shivamchudasama/KiaSorentoKeyCover_3DPrinting/(list of files, cad)

Other CAD files:
Hinge/hinge_rugged_upper_kia.stl
Magnet/magnet_trail_upper_kia.stl
Original/digital_only.stl
Snap/snap_ridge.3mf
Split/upper_flat.stl
Hinge/hinge_trail_upper_accent.stl
Magnet/magnet_ridge_upper_kia.stl
Original/from_openscad.stl
Snap/snap_trail_upper_kia.stl
Split/lower_flat.stl
Hinge/hinge_upper_kia.stl
Magnet/magnet_upper.stl
Snap/snap_ridge_upper_kia.stl
Hinge/hinge_trail_upper.stl
Magnet/magnet_trail_upper.stl
Snap/snap_upper.stl
Hinge/hinge_rugged_upper_accent.stl
Magnet/magnet_rugged_upper.stl
Snap/snap_ridge_upper.stl
Hinge/hinge_trail_upper_kia.stl
Magnet/magnet_upper_kia.stl
Snap/snap_rugged_upper.stl
Hinge/hinge_rugged_upper.stl
Magnet/magnet_rugged_upper_accent.stl
Snap/snap_trail_upper_accent.stl
Hinge/hinge_ridge_upper_kia.stl
Magnet/magnet_trail_upper_accent.stl
Snap/snap_rugged_upper_accent.stl
Hinge/hinge_ridge_upper.stl
Magnet/magnet_ridge_upper.stl
Snap/snap_trail_upper.stl
Hinge/hinge_upper.stl
Magnet/magnet_rugged_upper_kia.stl
Snap/snap_rugged_upper_kia.stl
Hinge/hinge_rugged_lower_accent.stl
Magnet/magnet_rugged_lower.stl
Snap/snap_upper_kia.stl
Hinge/hinge_rugged_lower.stl
Magnet/magnet_trail_lower_kia.stl
Snap/snap_rugged_lower.stl
Hinge/hinge_ridge_lower.stl
Magnet/magnet_ridge_lower_kia.stl
Snap/snap_rugged_lower_accent.stl
Hinge/hinge_trail_lower.stl
Magnet/magnet_lower_kia.stl
Snap/snap_trail_lower.stl
Hinge/hinge_lower.stl
Magnet/magnet_trail_lower.stl
Snap/snap_coupon.stl
Hinge/hinge_trail_lower_accent.stl
Magnet/magnet_trail_lower_accent.stl
Snap/snap_ridge_lower.stl
Hinge/hinge_lower_kia.stl
Magnet/magnet_lower.stl
Snap/snap_lower.stl
Hinge/hinge_rugged_lower_kia.stl
Magnet/magnet_ridge_lower.stl
Snap/snap_trail_lower_accent.stl
Hinge/hinge_ridge_lower_kia.stl
Magnet/magnet_rugged_lower_kia.stl
Snap/snap_lower_kia.stl
Hinge/hinge_trail_lower_kia.stl
Magnet/magnet_rugged_lower_accent.stl
Snap/snap_ridge_lower_kia.stl
Hinge/hinge_coupon.stl
Magnet/magnet_coupon.stl
Snap/snap_rugged_lower_kia.stl
Snap/snap_trail_lower_kia.stl
Original/split_grip_ridge.scad
kia_sorento_key_case_split.scad
Hinge/hinge_ridge.scad
Hinge/hinge_rugged.scad
Hinge/hinge_trail.scad
Magnet/magnet.scad
Magnet/magnet_ridge.scad
Magnet/magnet_rugged.scad
Magnet/magnet_trail.scad
Original/split.scad
Original/split_rugged.scad
Original/split_trail.scad
Snap/snap.scad
Snap/snap_ridge.scad
Snap/snap_trail.scad
Split/flat.scad
