shivamchudasama/KiaSorentoKeyCover_3DPrinting/(commit log)

2026-10-31 Add Kia Sorento key case: parametric source, exports and previews
    Two-part ASA case for the Kia Sorento digital key fob, split at Z = 0
    with selectable snap / hinge / magnet joints. STL and GLB files are
    stored in Git LFS; .codex/ local tool config is ignored.
    [kia_sorento_key_case_digital_only.scad, kia_sorento_key_case_digital_only.stl, kia_sorento_key_case_from_openscad.stl, kia_sorento_key_case_hinge_coupon.stl, kia_sorento_key_case_hinge_lower.stl, kia_sorento_key_case_hinge_upper.stl, kia_sorento_key_case_lower_flat.stl, kia_sorento_key_case_magnet_coupon.stl]
2026-10-31 Move snap and hinge latches off the button windows
    The latches covered the side windows that expose the fob's buttons.
    They now sit on the solid wall posts, each inside a local wall pad
    that encloses its pocket, so no new opening appears. Hooks use a 60°
    retaining face so the halves pull apart by hand.
    [kia_sorento_key_case_hinge_lower.stl, kia_sorento_key_case_hinge_upper.stl, kia_sorento_key_case_snap_lower.stl, kia_sorento_key_case_snap_upper.stl, kia_sorento_key_case_split.scad]
2026-10-31 Add grip-ridge variant of the snap and hinge cases
    Exploratory copy of the source with two pairs of opposing ridges, one
    ridge per half in each pair: round the top arc and along the open end.
    Their seam-side faces give a grip for pulling the halves apart. Each
    pair has its own on/off switch. The main design is unchanged.
    [kia_sorento_key_case_hinge_ridge_lower.stl, kia_sorento_key_case_hinge_ridge_upper.stl, kia_sorento_key_case_snap_ridge_lower.stl, kia_sorento_key_case_snap_ridge_upper.stl, kia_sorento_key_case_split_grip_ridge.scad]
2026-10-31 Organise files into per-design folders with short names
    Move the shared source and its inputs (master .scad files, base STL,
    logo, digital-only step) into Original/, and each design's exports into
    Snap/, Hinge/, Magnet/ and Split/. Drop the kia_sorento_key_case_ prefix
    from every file name.
    Each design folder gets a thin .scad wrapper that includes the master
    from Original/ and fixes joint_style, so a design can be opened on its
    own while all parameters stay in one place. The masters change only in
    the base STL's import path.
    Every exported part renders byte-identical through the wrappers to the
    previous layout; the snap, hinge and magnet renders also match the
    committed STLs byte for byte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
    [digital_only.scad, digital_only.stl, flat.scad, from_openscad.stl, hinge.scad, hinge_coupon.stl, hinge_lower.stl, hinge_ridge.scad]
2026-10-31 Drop the hinge's top grip ridge and add grip ridges to the magnet case
    The hinge case is pinned at the top arc, so its top ridge pair did nothing;
    it now keeps only the open-end pair. The magnet case gets both pairs, as on
    the snap case, through a new Magnet/magnet_ridge.scad wrapper.
    grip_ridges() takes top/end arguments defaulting to the grip_ridge_* switches.
    Snap ridge exports re-render byte-identical. Re-exported the hinge ridge
    halves and preview; added the magnet ridge halves and preview.
    [hinge_ridge_lower.stl, hinge_ridge_upper.stl, magnet_ridge.scad, magnet_ridge_lower.stl, magnet_ridge_upper.stl, split_grip_ridge.scad]
2026-10-31 Add rugged and trail styled variants of the snap, hinge and magnet cases
    Two styled copies of the master, both two-colour (body + accent STL per
    half, colour_part = all / body / accent) with the joints unchanged:
    - rugged (split_rugged.scad): orange seam band on the wall posts, crossed
    by the grey latch pads and magnet lugs; grey corner bumpers flush with
    the faces; debossed window bezel, panel, slots, grip lines and back
    emblem; front logo as a flush orange inlay.
    - trail (split_trail.scad): orange frames round the side windows, a
    full-height top-left cap, a right tab and a boot over the open end with
    the logo debossed in it; a flush panel in a sunken, stippled border.
    Both keep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
    [hinge_rugged.scad, hinge_rugged_lower.stl, hinge_rugged_lower_accent.stl, hinge_rugged_upper.stl, hinge_rugged_upper_accent.stl, hinge_trail.scad, hinge_trail_lower.stl, hinge_trail_lower_accent.stl]
2026-10-31 Update CLAUDE.md for the rugged and trail variants
    Layout, conventions (styled additions, colour split, causes of broken
    faces), verification (window and colour-split checks, magnet booleans in
    OpenSCAD) and the LFS figures.
2026-11-01 Add a two-colour KIA logo inlay to every lower half
    The base model engraves the KIA logo only 0.2 mm deep in the lower face.
    Every master now traces it from the STL (kia_2d), cuts it 0.6 mm deep and
    exports the flush inlay that fills it as colour_part = "kia". Lower halves,
    trail lower accents and all assembly GLBs are re-exported; uppers, coupons
    and rugged lower accents are unchanged. README covers printing the logo.
    [flat.scad, hinge.scad, hinge_lower.stl, hinge_lower_kia.stl, hinge_ridge.scad, hinge_ridge_lower.stl, hinge_ridge_lower_kia.stl, hinge_rugged.scad]
2026-11-01 Stiffen the snap latches and preload the hooks
    The 1.2 mm arms were too weak to click and the small positive Z play
    jammed the hooks. Thicken the arms to 1.6 mm, deepen the hooks to
    1.0 mm, lower the arm tip to -8.45 so the lip over the hook is ~0.8-1 mm
    thick, free the arm up to Z 5.4 for a longer, lower-strain flex, and
    preload the hook 0.1 mm onto its retaining face (flat 90 deg faces keep
    play). The snap coupon follows the new arm length.
    Carried into the ridge, rugged and trail copies; snap and hinge exports
    and GLBs regenerated.
    [hinge_lower.stl, hinge_ridge_lower.stl, hinge_ridge_upper.stl, hinge_rugged_lower.stl, hinge_rugged_lower_accent.stl, hinge_rugged_upper.stl, hinge_rugged_upper_accent.stl, hinge_trail_lower.stl]
2026-11-01 Update CLAUDE.md before every commit; note the hook preload
    Replace the ask-after-change routine with updating CLAUDE.md just
    before each commit, in the same commit. Document the snap hooks'
    0.1 mm preload (and its overlap in the assembled-intersection check)
    and refresh the LFS storage figures.
2026-11-01 Inlay the B3D Labs logo in the upper half, placed like the KIA logo
    The 26 mm debossed logo in the middle of the upper face becomes a 9 mm
    two-colour inlay: cut 0.6 mm deep, at the KIA logo's height and, seen
    from outside, near the same left post. On the upper half,
    colour_part = "kia" now gives its inlay, so one filament prints both
    logos (9 mm keeps its strokes and gaps at about one nozzle line). Trail
    centres it on the boot; rugged's upper panel starts below it.
    Carried into the ridge, rugged and trail copies; every upper half and
    GLB re-exported, plus the new <joint>_*upper_kia.stl inlays.
    [hinge_ridge_upper.stl, hinge_ridge_upper_kia.stl, hinge_rugged_upper.stl, hinge_rugged_upper_accent.stl, hinge_rugged_upper_kia.stl, hinge_trail_upper.stl, hinge_trail_upper_accent.stl, hinge_trail_upper_kia.stl]
2026-11-01 Add a Bambu Studio print plate for the snap ridge case
    Snap/snap_ridge.3mf holds both snap_ridge halves face down, each an
    object with a body part on filament 1 and its logo inlay on filament 2.
    It carries no Bambu Application tag: claiming to be a Bambu project
    without the rest of one crashes Bambu Studio's loader.
    [snap_ridge.3mf]
